arKDuino/esp8266_wifi_switch/(list of files, drawings)

Other design files:
easyeda_schematic/PCB.json
easyeda_schematic/schematic.json
