arKDuino/esp8266_wifi_switch/html_tests/todo.txt

copy .h files from sketch to this folder, using makefile
gitignore sketch .h files
