arKDuino/esp8266_wifi_switch/sketch/sketch.ino

//uncomment this when using a new es8266
//#define ERASE_EEPROM_NEW_CHIP true

#include <ESP8266WebServer.h>
#include <EEPROM.h>
#include <Wire.h>
#include <ArduinoJson.h>
#include <user_interface.h>
#include "page_generator.h"

#define PCF8574_ADDRESS 32 //PCF8574 pins A0, A1 and A2 wired to ground
#define PCF8574_RELAY_PIN 0b00000001 //PCF8574 RELAY PIN
#define PCF8574_STATUS_PIN 0b00000010 //PCF8574 LED PIN
#define PCF8574_RESET_PIN 0b00000100 //PCF8574 RESET BUTTON
#define GPIO_SDA 4 //esp8266 gpio4
#define GPIO_SCL 5 //esp8266 gpio5
#define EEPROM_SIZE 512
#define MAX_SSID_LENGTH 32 //according to 802.11
#define MAX_PASSWD_LENGTH 64 //according to 802.11 - WPA specification

//some relays have NC and NO pins inverted
const bool INVERTED_NC_NO_PINS = true;

typedef struct
{
  char* title = NULL;
  char* ssid = NULL;
  char* passwd = NULL;
  bool use_DHCP = false;
  char* deviceIP = NULL; //format: 0.0.0.0
  char* deviceGateway = NULL; //format: 0.0.0.0
  char* deviceSubnet = NULL; //format: 0.0.0.0
} EEPROM_DATA_STRUCT;

const char* TEXT_HTML = "text/html";

ESP8266WebServer server(80);
uint8_t mac[6];
uint8_t pcf8574_pins = 0; //PCF8574 state
EEPROM_DATA_STRUCT wifi_data;

void seeEEPROM()
{
  Serial.println(F("Actual EEPROM content:"));
  char content[EEPROM_SIZE];
  for (int i = 0; i < EEPROM_SIZE; i++)
  {
    content[i] = EEPROM.read(i);
  }

  Serial.println(content);
}

void loadDataFromEEPROM(EEPROM_DATA_STRUCT* buf)
{
  char content[EEPROM_SIZE];
  for (int i = 0; i < EEPROM_SIZE; i++)
  {
    content[i] = EEPROM.read(i);
  }

  Serial.println(F("Converting this data from EEPROM into JSON:"));
  Serial.println(content);

  StaticJsonBuffer<EEPROM_SIZE> jsonBuffer;
  JsonObject& root = jsonBuffer.parseObject(content);

  //strdup will create another pointer dinamically alocated
  //so it will resides on memory forever
  buf->title = strdup(root["title"]);
  buf->ssid = strdup(root["ssid"]);
  buf->passwd = strdup(root["passwd"]);
  buf->use_DHCP = root["DHCP"];
  buf->deviceIP = strdup(root["deviceIP"]);
  buf->deviceGateway = strdup(root["deviceGateway"]);
  buf->deviceSubnet = strdup(root["deviceSubnet"]);

}

void saveDataToEEPROM(EEPROM_DATA_STRUCT* buf)
{
  //convert to JSON
  StaticJsonBuffer<EEPROM_SIZE> jsonBuffer;
  JsonObject& root = jsonBuffer.createObject();
  root["title"] = buf->title;
  root["ssid"] = buf->ssid;
  root["passwd"] = buf->passwd;
  root["DHCP"] = buf->use_DHCP;
  root["deviceIP"] = buf->deviceIP;
  root["deviceGateway"] = buf->deviceGateway;
  root["deviceSubnet"] = buf->deviceSubnet;

  //get a char array
  char json_chars[EEPROM_SIZE];
  root.printTo(json_chars, EEPROM_SIZE);
  Serial.println(F("Saving this JSON into EEPROM:"));
  Serial.println(json_chars);

  //write on EEPROM memory
  for (int i = 0; i < strlen(json_chars); i++)
  {
    EEPROM.write(i, json_chars[i]);
  }

  //null terminating character
  EEPROM.write(strlen(json_chars), '\0');

  //write null on the remaining space
  for (int i = strlen(json_chars) + 1; i < EEPROM_SIZE; i++)
  {
    EEPROM.write(i, 0);
  }

  EEPROM.commit();
}

void updatePCF8574()
{
  //send status to PCF8574
  Wire.beginTransmission(PCF8574_ADDRESS);
  Wire.write(pcf8574_pins);
  Wire.endTransmission();
}

void blinkStatusLights(int times)
{
  //PCF8574 is wired to leds in current sinking mode
  for (int i = 0; i < times; i++)
  {
    turnLedOn();
    delay(300);

    turnLedOff();
    delay(300);
    yield();
  }
}

void turnLedOff()
{
  //PCF8574 is wired to led in current sinking mode, so 0 turn ON, and 1 turn OFF
  pcf8574_pins |= PCF8574_STATUS_PIN;
  updatePCF8574();
}

void turnLedOn()
{
  //PCF8574 is wired to led in current sinking mode, so 0 turn ON, and 1 turn OFF
  pcf8574_pins &= ~(PCF8574_STATUS_PIN);
  updatePCF8574();
}

void turnRelayOn()
{
  if (INVERTED_NC_NO_PINS)
  {
    //ON is low when inverted
    pcf8574_pins &= ~(PCF8574_RELAY_PIN);
  }
  else
  {
    pcf8574_pins |= PCF8574_RELAY_PIN;
  }

  updatePCF8574();
}

void turnRelayOff()
{
  if (INVERTED_NC_NO_PINS)
  {
    //OFF is high when inverted
    pcf8574_pins |= PCF8574_RELAY_PIN;
  }
  else
  {
    pcf8574_pins &= ~(PCF8574_RELAY_PIN);
  }

  updatePCF8574();
}

void setupServerConfigMode()
{
  server.on("/", HTTP_GET, handleConfigPage);
  server.on("/setConfig", HTTP_POST, handleSetConfig);
  server.on("/setConfig", HTTP_GET, handleConfigPage);
  server.begin();

  Serial.println(F("HTTP server started in config mode"));
}

void handleSetConfig()
{
  char* _ssid = strdup(server.arg("txtSSID").c_str());
  //data validation
  if (strlen(_ssid) <= 1 || strlen(_ssid) > MAX_SSID_LENGTH - 1)
  {
    std::string html = getConfigurationInvalidSSID();
    String s_html = String(html.c_str());
    ESP.wdtFeed();
    server.send(200, TEXT_HTML, s_html);
    return;
  }

  char* _passwd = strdup(server.arg("txtPASSWORD").c_str());
  //data validation
  if (strlen(_passwd) <= 1 || strlen(_passwd) > MAX_PASSWD_LENGTH - 1)
  {
    std::string html = getConfigurationInvalidPASSWD();
    String s_html = String(html.c_str());
    ESP.wdtFeed();
    server.send(200, TEXT_HTML, s_html);
    return;
  }

  char* _dhcp = strdup(server.arg("chkDHCP").c_str());
  char* _ip = strdup(server.arg("txtIP").c_str());
  char* _subnet = strdup(server.arg("txtSubnet").c_str());
  char* _gateway = strdup(server.arg("txtGateway").c_str());

  //limit title length
  const int TITLE_MAX_LENGTH = 32;
  char _title[TITLE_MAX_LENGTH];
  strncpy(_title, server.arg("txtTitle").c_str(), TITLE_MAX_LENGTH - 1);
  _title[TITLE_MAX_LENGTH] = '\0';

  if (strcmp(_dhcp, "on") != 0) //validate ip adresses only if dhcp is off
  {
    IPAddress ip_validator;
    if (!ip_validator.fromString(_ip))
    {
      std::string html = getConfigurationInvalidIP();
      String s_html = String(html.c_str());
      ESP.wdtFeed();
      server.send(200, TEXT_HTML, s_html);
      return;
    }

    IPAddress subnet_validator;
    if (!subnet_validator.fromString(_subnet))
    {
      std::string html = getConfigurationInvalidSubnet();
      String s_html = String(html.c_str());
      ESP.wdtFeed();
      server.send(200, TEXT_HTML, s_html);
      return;
    }

    IPAddress gateway_validator;
    if (!gateway_validator.fromString(_gateway))
    {
      std::string html = getConfigurationInvalidGateway();
      String s_html = String(html.c_str());
      ESP.wdtFeed();
      server.send(200, TEXT_HTML, s_html);
      return;
    }
  }

  Serial.println(F("New settings received"));
  Serial.print(F("Title:"));
  Serial.println(_title);
  Serial.print(F("SSID:"));
  Serial.println(_ssid);
  Serial.print(F("PASSWORD: "));
  Serial.println(_passwd);
  Serial.print(F("USE DHCP: "));
  Serial.println(_dhcp);
  Serial.print(F("IP: "));
  Serial.println(_ip);
  Serial.print(F("SUBNET: "));
  Serial.println(_subnet);
  Serial.print(F("GATEWAY: "));
  Serial.println(_gateway);

  wifi_data.title = _title;
  wifi_data.ssid = _ssid;
  wifi_data.passwd = _passwd;
  if (strcmp(_dhcp, "on") == 0)
  {
    wifi_data.use_DHCP = true;
  }
  else
  {
    wifi_data.use_DHCP = false;
  }
  wifi_data.deviceIP = _ip;
  wifi_data.deviceSubnet = _subnet;
  wifi_data.deviceGateway = _gateway;
  saveDataToEEPROM(&wifi_data);

  std::string html = getConfigurationSavedPage();
  String s_html = String(html.c_str());
  ESP.wdtFeed();
  server.send(200, TEXT_HTML, s_html);
}

void handleConfigPage()
{
  std::string html = getConfigPage(mac);
  String s_html = String(html.c_str());
  ESP.wdtFeed();
  server.send(200, TEXT_HTML, s_html);
}

void setupServerNormalMode()
{
  server.on("/", handleMainPage);
  server.on("/setRelayOn", HTTP_GET, handleMainPage);
  server.on("/setRelayOff", HTTP_GET, handleMainPage);
  server.on("/setRelayOn", HTTP_POST, handleTurnOn);
  server.on("/setRelayOff", HTTP_POST, handleTurnOff);
  server.begin();

  Serial.println(F("HTTP server started in normal mode"));
}

void handleMainPage()
{
  std::string html = getSwitchPage(wifi_data.title);
  String s_html = String(html.c_str());
  ESP.wdtFeed();
  server.send(200, TEXT_HTML, s_html);
}

void handleTurnOn()
{
  turnRelayOn();
  Serial.println(F("handleTurnOn();"));
  handleMainPage();
}

void handleTurnOff()
{
  turnRelayOff();
  Serial.println(F("handleTurnOff();"));
  handleMainPage();
}

void eraseEEPROM()
{
  Serial.println(F("ERASING FOR NEW CHIP..."));
  for (int i = 0; i < EEPROM_SIZE; i++)
  {
    EEPROM.write(i, 0);
  }
  EEPROM.commit();

  Serial.println(F("...ERASED!"));

  wifi_data.title = "";
  wifi_data.ssid = "";
  wifi_data.passwd = "";
  wifi_data.use_DHCP = false;
  wifi_data.deviceIP = "";
  wifi_data.deviceGateway = "";
  wifi_data.deviceSubnet = "";
  saveDataToEEPROM(&wifi_data);

  Serial.println(F("REMOVE #define ERASE_EEPROM_NEW_CHIP AND BURN FIRMWARE AGAIN!!"));
  blinkStatusLights(255);
  while (true);
}

bool isConfigModeButtonPressed()
{
  uint8_t _data = 0;
  //i2c communication, request 1 byte
  Wire.requestFrom(PCF8574_ADDRESS, 1);
  if (Wire.available())
  {
    _data = Wire.read();
  }
  Wire.endTransmission();

  if (_data & PCF8574_RESET_PIN)
  {
    return true;
  }

  return false;
}

void setup() {
  //initialize Serial
  Serial.begin(115200);
  delay(100);

  //init I2C
  Wire.begin(GPIO_SDA, GPIO_SCL);
  Wire.setClock(100000); //ensure clock of 100kHz

  //relay ON by default
  turnRelayOn();
  turnLedOff();

  //begin EEPROM
  Serial.println(F("Initializing EEPROM..."));
  EEPROM.begin(EEPROM_SIZE);
  
#ifdef ERASE_EEPROM_NEW_CHIP
  eraseEEPROM();
#endif

  //load data from EEPROM
  loadDataFromEEPROM(&wifi_data);

  //debug messages
  Serial.print(F("SSID:"));
  Serial.println(wifi_data.ssid);
  Serial.print(F("PASSWORD:"));
  Serial.println(wifi_data.passwd);

  //get MAC Address
  WiFi.macAddress(mac);

  //Debug messages
  Serial.print(F("MAC: "));
  Serial.print(mac[0], HEX);
  Serial.print(F(":"));
  Serial.print(mac[1], HEX);
  Serial.print(F(":"));
  Serial.print(mac[2], HEX);
  Serial.print(F(":"));
  Serial.print(mac[3], HEX);
  Serial.print(F(":"));
  Serial.print(mac[4], HEX);
  Serial.print(F(":"));
  Serial.println(mac[5], HEX);

  //check if button was pressed when the device was turned on
  //enter in config mode
  if (isConfigModeButtonPressed())
  {
    turnRelayOff();
    blinkStatusLights(5);
    Serial.println(F("Entering in config mode..."));
    WiFi.softAP("configuracao", "configuracao");
    setupServerConfigMode();
    return;    
  }

  //Connect to WiFi network
  Serial.println();
  Serial.print(F("Connecting to "));
  Serial.println(wifi_data.ssid);
  WiFi.mode(WIFI_STA);

  if (wifi_data.use_DHCP)
  {
    Serial.println(F("Using DHCP..."));
    //nothing to do, DHCP is default
  }
  else
  {
    Serial.println(F("Using static IP..."));
    // NETWORK: Static IP details...
    IPAddress ip;
    Serial.print(F("IP: "));
    Serial.println(wifi_data.deviceIP);
    ip.fromString(wifi_data.deviceIP);

    IPAddress subnet;
    Serial.print(F("Subnet: "));
    Serial.println(wifi_data.deviceGateway);
    subnet.fromString(wifi_data.deviceSubnet);

    IPAddress gateway;
    Serial.print(F("Gateway: "));
    Serial.println(wifi_data.deviceGateway);
    gateway.fromString(wifi_data.deviceGateway);

    WiFi.config(ip, gateway, subnet);
  }

  WiFi.begin(wifi_data.ssid, wifi_data.passwd);

  while (WiFi.status() != WL_CONNECTED)
  {
    delay(100);
  }

  Serial.println();
  Serial.println(F("WiFi connected"));

  setupServerNormalMode();

  //blink lighst to tell everything is OK
  blinkStatusLights(2);
}

void loop()
{
  server.handleClient();
}
