arKDuino/esp8266_wifi_switch/sketch/constants_lang_pt.h

//PT-BR language specific constants

#include <string>

#ifndef constants_lang_pt_h
#define constants_lang_pt

const std::string text_config_saved_success = "Configuração gravada com sucesso! Reinicie.";
const std::string text_invalid_ssid = "SSID inválido!";
const std::string text_invalid_ip = "ERRO: IP inválido!";
const std::string text_invalid_subnet = "ERRO: Subnet inválida!";
const std::string text_invalid_gateway = "ERRO: Gateway inválido!";
const std::string text_invalid_password = "ERRO: Senha inválida!";
const std::string text_last_ip = "Último IP associado";
const std::string text_device_name = "Nome do dispositivo";
const std::string text_ssid_name = "Nome da rede";
const std::string text_wifi_passowrd = "Senha";
const std::string text_enable_dhcp = "Habilitar DHCP";
const std::string text_button_turn_on = "LIGAR";
const std::string text_button_turn_off = "DESLIGAR";

#endif
