arKDuino/esp8266_wifi_switch/(commit log)

2018-04-19 arduino sketch
2018-04-19 added PCB schematics on EasyEda
    [PCB.json, schematic.json]
2018-05-23 makefile bug, final schematic and board photo
    [sketch.ino]
2018-05-28 pcb update
    [PCB.json, schematic.json]
2018-06-03 added varistor on pcb
    [PCB.json, schematic.json]
2018-07-06 board photo
2018-07-09 pcb and schematic in png
2018-07-09 schematic and pcb designs
2018-07-09 removed old schematics and add gerber
    [PCB.json, schematic.json]
2018-07-13 pcb fix
2018-07-21 fix check config mode
    [sketch.ino]
